JulianDomingo/EC60/(commit log)

2023-11-17 Updated sheets
    [EC60-Rev_1_1_1.kicad_sch, analog.kicad_sch, matrix.kicad_sch, mounting.kicad_sch]
2024-03-03 Update
    Updated the License for the project and relative details.
    [EC60-Rev_1_1_1.kicad_sch, analog.kicad_sch, matrix.kicad_sch, mounting.kicad_sch]
