JulianDomingo/EC60/(notices)

Notices in the files:
PCB/Rev_1_1_1/mounting.kicad_sch:
CC-BY-NC-SA-4.0
